kian-mc/Stabalized-car-mk1/wiring scematic.png

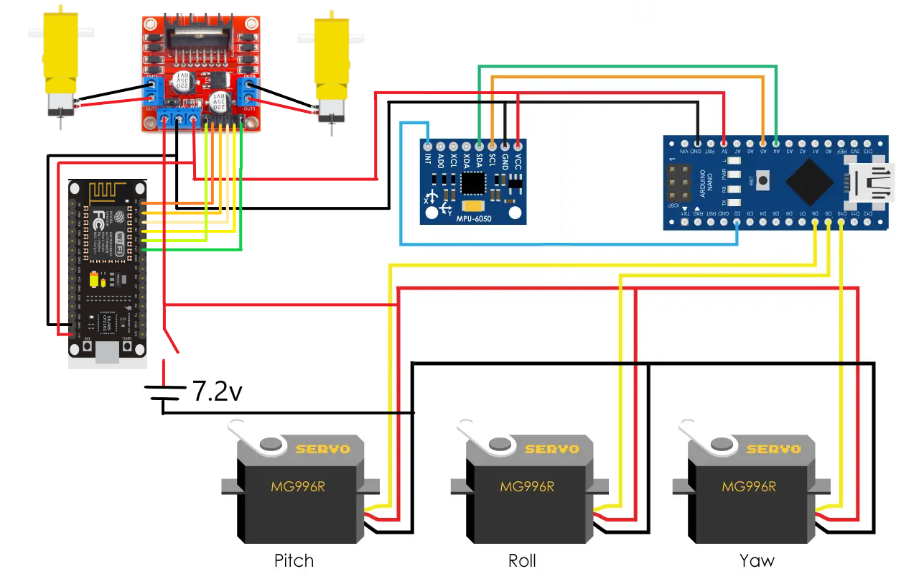
wiring scematic.png
