kian-mc/Stabalized-car-mk1/IMG-2784.png

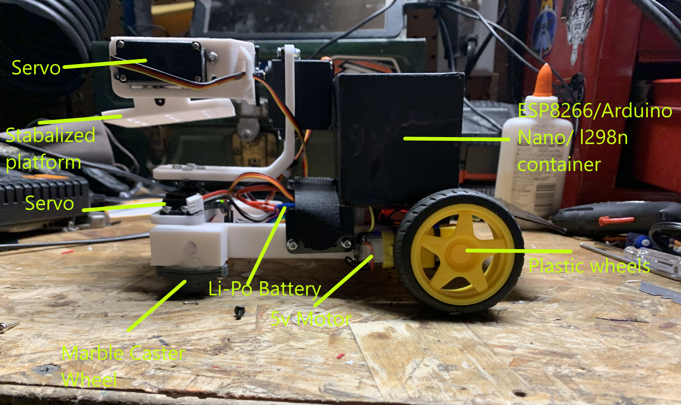
IMG-2784.png
