kian-mc/Stabalized-car-mk1/project poster.pdf

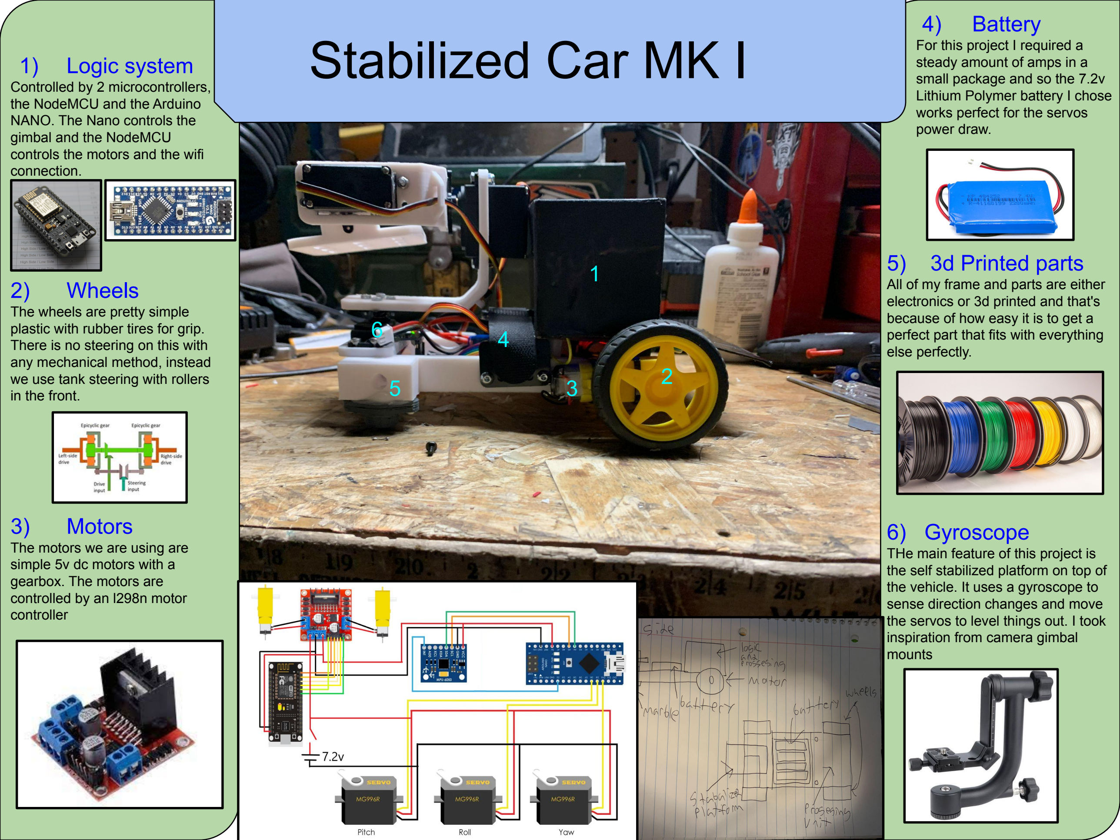
[picture p3: figure]
Stabilized Car MK I; 2) Wheels; The wheels are pretty simple plastic with rubber tires for grip. There is no steering on this with any mechanical method, instead we use tank steering with rollers in the front.; 1) Logic system; Controlled by 2 microcontrollers, the NodeMCU and the Arduino NANO. The Nano controls the gimbal and the NodeMCU controls the motors and the wifi connection.; 3) Motors; The motors we are using are simple 5v dc motors with a gearbox. The motors are controlled by an l298n motor controller; 5) 3d Printed parts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
