kian-mc/Stabalized-car-mk1/IMG-2783.JPG

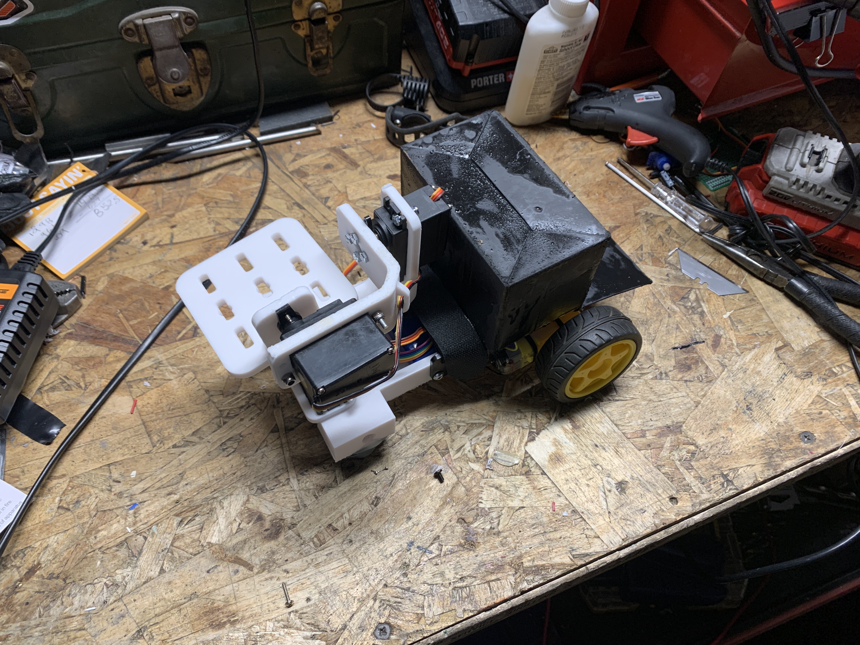
IMG-2783.JPG
