kian-mc/Stabalized-car-mk1/Base 03 - Pitch servo.STL

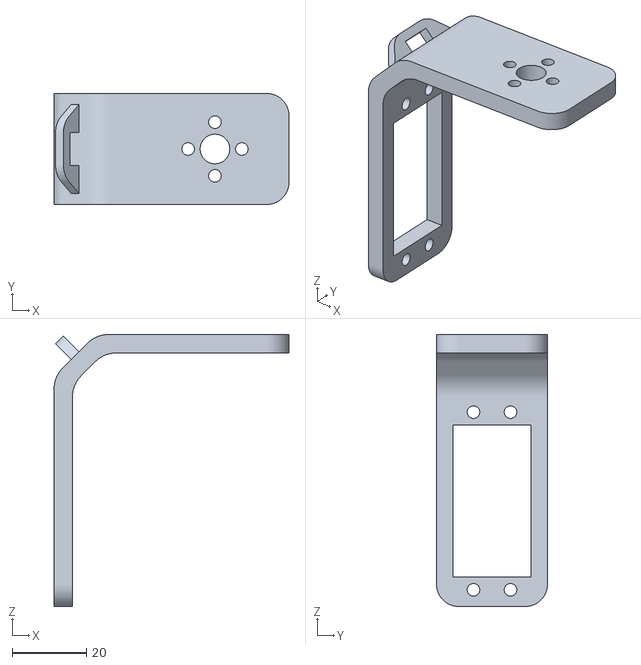
[picture p5: CAD file, 2023-05-10]
Base 03 - Pitch servo.STL
63.5 x 30.0 x 73.5
