kian-mc/Stabalized-car-mk1/Top platform.STL

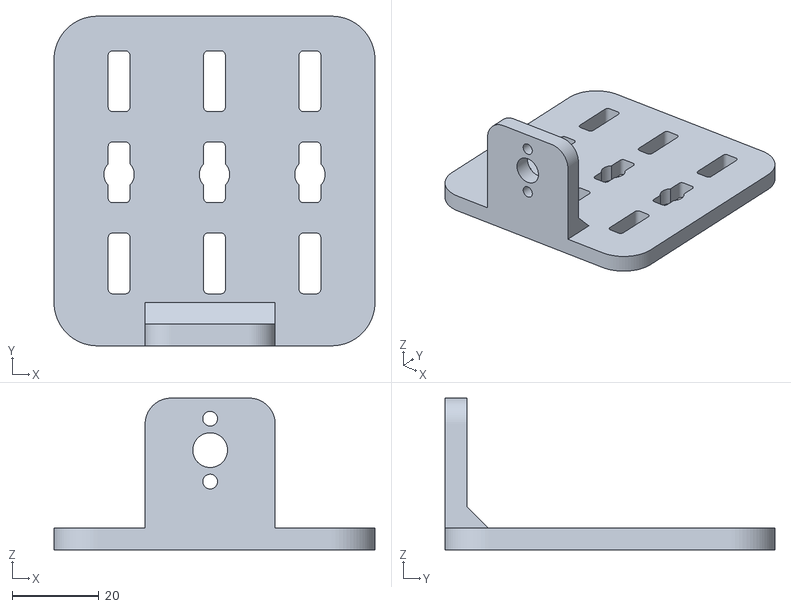
[picture p6: CAD file, 2023-05-10]
Top platform.STL
74.0 x 76.0 x 35.0
