kian-mc/Stabalized-car-mk1/Base 02 - Roll servo.STL

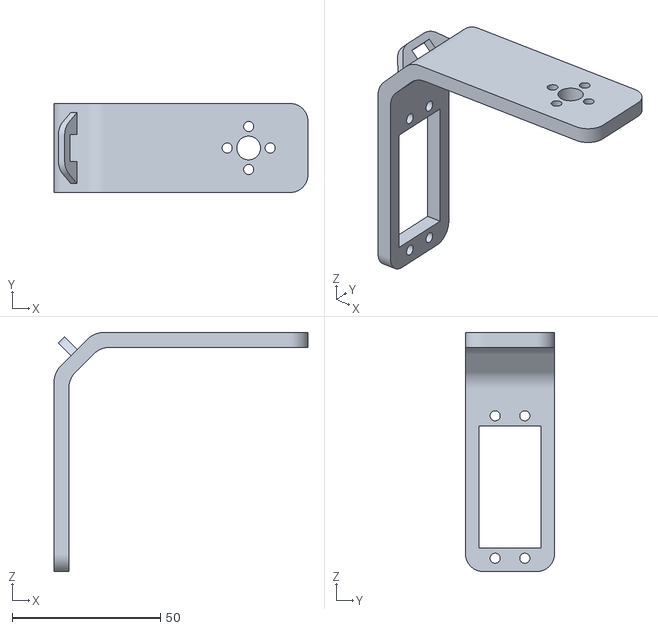
[picture p7: CAD file, 2023-05-10]
Base 02 - Roll servo.STL
85.6 x 30.0 x 80.6
