kian-mc/Stabalized-car-mk1/gyroscope_ardu_mk1.ino

//ARDUINO NANO CODE FOR GIMBAL MOUNT



//read the mpu
#include "I2Cdev.h"
//read the mpu
#include "MPU6050_6Axis_MotionApps20.h"

//control the servos
#include <Servo.h>

//define the mpu
MPU6050 mpu;

// Define the 3 servo motors
Servo servo0;
Servo servo1;
Servo servo2;
float correct;
int j = 0;

#define OUTPUT_READABLE_YAWPITCHROLL

#define INTERRUPT_PIN 2 

// MPU control/status vars
bool dmpReady = false;  // set true if DMP init was successful
uint8_t mpuIntStatus;   // holds interrupt status byte from MPU
uint8_t devStatus;      // return status
uint16_t packetSize;    // expected packet size 
uint16_t fifoCount;     // count of all bytes currently in FIFO
uint8_t fifoBuffer[64]; // FIFO storage buffer

// orientation/ motion variables 
Quaternion q;           // [w, x, y, z]         quaternion container
VectorInt16 aa;         // [x, y, z]            accel sensor measurements
VectorInt16 aaReal;     // [x, y, z]            gravity-free accel sensor measurements
VectorInt16 aaWorld;    // [x, y, z]            world-frame accel sensor measurements
VectorFloat gravity;    // [x, y, z]            gravity vector
float euler[3];         // [psi, theta, phi]    Euler angle container
float ypr[3];           // [yaw, pitch, roll]   yaw/pitch/roll container and gravity vector







volatile bool mpuInterrupt = false;     // indicates whether MPU interrupt pin has gone high
void dmpDataReady() {
  mpuInterrupt = true;
}


void setup() {
  // join I2C bus (I2Cdev library doesn't do this automatically)
#if I2CDEV_IMPLEMENTATION == I2CDEV_ARDUINO_WIRE
  Wire.begin();
  Wire.setClock(400000); // 400kHz I2C clock. Comment this line if having compilation difficulties
#elif I2CDEV_IMPLEMENTATION == I2CDEV_BUILTIN_FASTWIRE
  Fastwire::setup(400, true);
#endif


  //intitalizing mpu and devstatus
  mpu.initialize();
  pinMode(INTERRUPT_PIN, INPUT);
  devStatus = mpu.dmpInitialize();
  // gyroscope offsets for accuracy
  mpu.setXGyroOffset(17);
  mpu.setYGyroOffset(-69);
  mpu.setZGyroOffset(27);
  mpu.setZAccelOffset(1551);

  // make sure it worked
  if (devStatus == 0) {
    // turn on the DMP
    mpu.CalibrateAccel(6);
    mpu.CalibrateGyro(6);
    mpu.PrintActiveOffsets();
    mpu.setDMPEnabled(true);

    attachInterrupt(digitalPinToInterrupt(INTERRUPT_PIN), dmpDataReady, RISING);
    mpuIntStatus = mpu.getIntStatus();

    // set our DMP Ready flag so the main loop() function knows it's okay to use it
    //Serial.println(F("DMP ready! Waiting for first interrupt..."));
    dmpReady = true;

    // get expected DMP packet size for later comparison
    packetSize = mpu.dmpGetFIFOPacketSize();
  }

  // Define the pins to which the 3 servo motors are connected
  servo0.attach(5);
  servo1.attach(6);
  servo2.attach(9);
}

void loop() {
  // if programming failed, don't try to do anything
  if (!dmpReady) return;

  // wait for MPU interrupt or extra packet(s) available
  while (!mpuInterrupt && fifoCount < packetSize) {
    if (mpuInterrupt && fifoCount < packetSize) {
      // try to get out of the infinite loop
      fifoCount = mpu.getFIFOCount();
    }
  }

  // reset interrupt flag and get INT_STATUS byte
  mpuInterrupt = false;
  mpuIntStatus = mpu.getIntStatus();

  // get current FIFO count
  fifoCount = mpu.getFIFOCount();

  if (mpuIntStatus & _BV(MPU6050_INTERRUPT_DMP_INT_BIT)) {
    // wait for correct available data length, should be a VERY short wait
    while (fifoCount < packetSize) fifoCount = mpu.getFIFOCount();

    // read a packet from FIFO
    mpu.getFIFOBytes(fifoBuffer, packetSize);

    // track FIFO count here in case there is > 1 packet available
    fifoCount -= packetSize;

    // Get Yaw, Pitch and Roll values
    mpu.dmpGetQuaternion(&q, fifoBuffer);
    mpu.dmpGetGravity(&gravity, &q);
    mpu.dmpGetYawPitchRoll(ypr, &q, &gravity);

    // Yaw, Pitch, Roll values - Radians to degrees
    ypr[0] = ypr[0] * 180 / M_PI;
    ypr[1] = ypr[1] * 180 / M_PI;
    ypr[2] = ypr[2] * 180 / M_PI;
    
    // Skip 300 readings to calibrate
    if (j <= 300) {
      correct = ypr[0]; //capture last yaw value to stabalize to
      j++;
    }
    // After 300 readings
    else {
      ypr[0] = ypr[0] - correct; // Set the Yaw to 0 deg
      //map the mpu values to a servo readable 0-180 degree
      int servo0Value = map(ypr[0], -90, 90, 0, 180);
      int servo1Value = map(ypr[1], -90, 90, 0, 180);
      int servo2Value = map(ypr[2], -90, 90, 180, 0);
      
      // Control the servos according to the MPU6050 orientation
      servo0.write(servo0Value);
      servo1.write(servo1Value);
      servo2.write(servo2Value);

      

    }
  }
}
